JDMarc/albatross/output/airshot-pneumatics/instrument-eco-amber-inverse.png

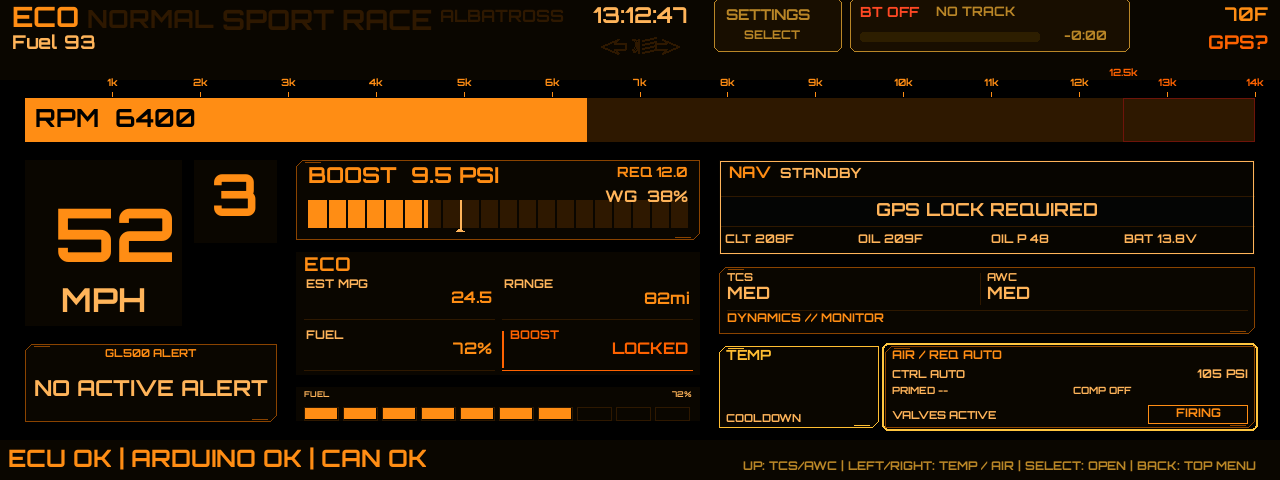
output/airshot-pneumatics/instrument-eco-amber-inverse.png
