JDMarc/albatross/output/airshot-pneumatics/instrument-eco-night-ops-inverse.png

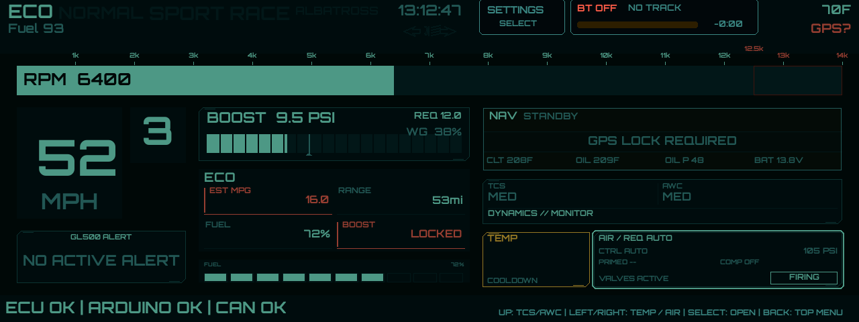
output/airshot-pneumatics/instrument-eco-night-ops-inverse.png
