JDMarc/albatross/output/airshot-pneumatics/instrument-sport-amber-inverse.png

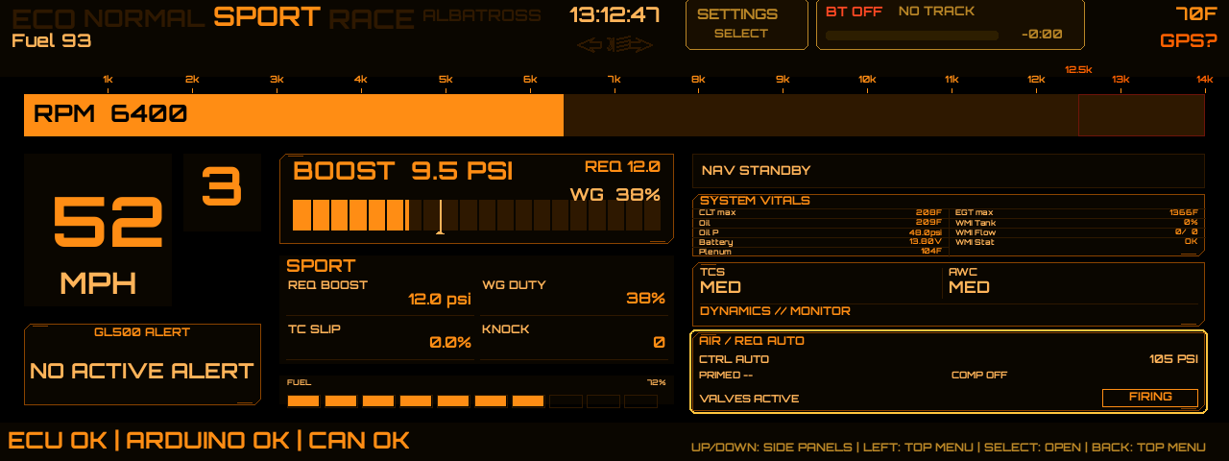
output/airshot-pneumatics/instrument-sport-amber-inverse.png
