JDMarc/albatross/output/airshot-pneumatics/instrument-sport-night-ops-inverse.png

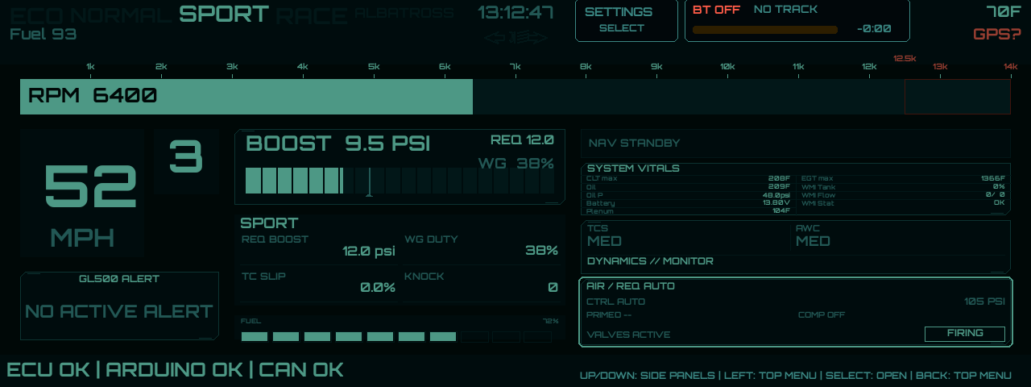
output/airshot-pneumatics/instrument-sport-night-ops-inverse.png
