JDMarc/albatross/output/post/startup-post-1280.png

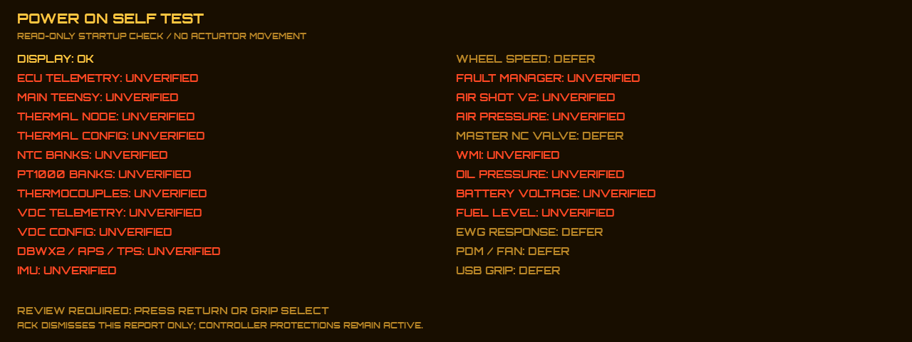
output/post/startup-post-1280.png
