JDMarc/albatross/output/post/startup-post-1920.png

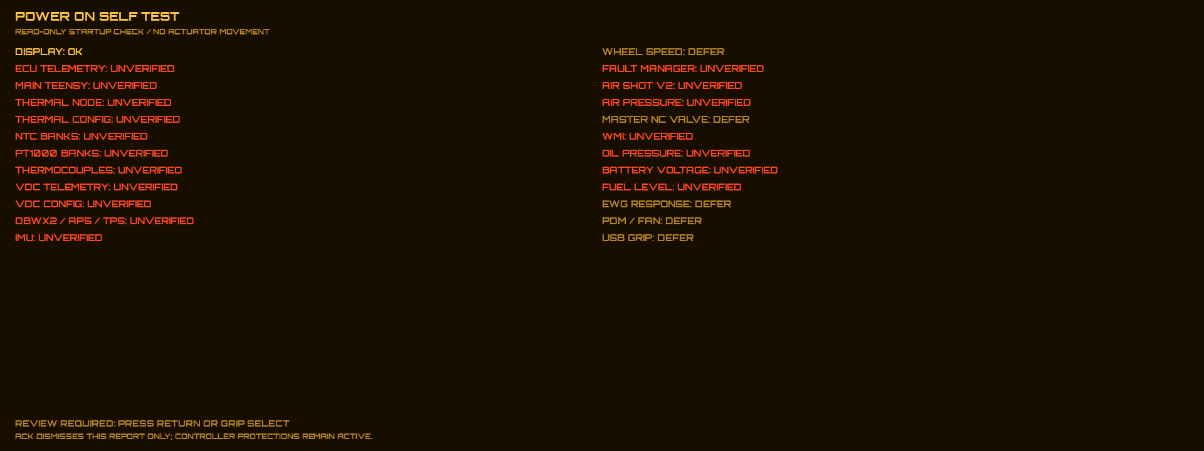
output/post/startup-post-1920.png
