JDMarc/albatross/arduino/teensy41/albatross_thermal_node/sensor_config.h

#pragma once
#include <Arduino.h>

enum class SensorTechnology : uint8_t { K_TYPE, IAT_NTC, COOLANT_NTC, PT1000, DISABLED };
enum class SourceBus : uint8_t { MAX31856, ADS1115, MAX31865, NONE };

struct SensorConfig {
  uint8_t id;
  const char* key;
  SensorTechnology technology;
  SourceBus bus;
  uint8_t channel;
  uint16_t sample_period_ms;
  uint16_t report_period_ms;
  float filter_tau_s;
  float derivative_tau_s;
  float minimum_c;
  float maximum_c;
  int32_t raw_minimum;
  int32_t raw_maximum;
  bool enabled;
  float pullup_ohm, r0_ohm, t0_c, beta_k;
};

constexpr size_t THERMAL_SENSOR_COUNT = 32;
extern const SensorConfig SENSOR_CONFIG[THERMAL_SENSOR_COUNT];
