JDMarc/albatross/(commit log)

2026-05-15 Add dual e-wastegate pins and wheel-speed CAN speedometer feed
2026-05-15 Align Arduino sketch pin mapping for Mega 2560 Rev3
2026-05-15 Fix Mega compile issues in Arduino sketch
    [albatross_controller.ino]
2026-05-16 Make HUD comm status line report FAULT when ECU/Arduino/CAN are absent
2026-05-16 Handle Windows UDP bind failures for demo listener with safe fallback
    [albatross_controller.ino, decode.py, ids.py]
2026-05-16 Fix demo responsiveness: dual UDP ports + live clock updates without telemetry
    [albatross_controller.ino, decode.py, ids.py]
2026-05-16 Add Arduino fuel telemetry path and large block-style HUD fuel gauge
2026-05-16 Expand safety supervisor for clutch-slip detection and critical-oil shutdown request logic
    [albatross_controller.ino, decode.py]
2026-05-16 Fix comm status false positives for Arduino/CAN with no telemetry
    [albatross_controller.ino, decode.py]
2026-05-16 Make POST render as typed terminal sequence with opaque background and staged results
2026-05-16 Fix demo UDP mapping and airshot charge selector
2026-05-16 Group CAN demo controls into ECU and Arduino sections
2026-05-16 Update README with accurate Arduino controller coverage
2026-05-16 Improve HUD media UI and show Bluetooth device list
2026-05-16 Fix menu focus gating and reposition right-side HUD controls
    [encode.py, ids.py]
2026-05-16 Prevent startup select bleed-through and tighten media tile control visibility
    [encode.py, ids.py]
2026-05-17 Fix selector positioning with right-anchored cluster layout
    [encode.py, ids.py]
2026-05-17 Fix CAN stale recovery using live-signal signature and align play time
    [encode.py, ids.py]
2026-05-17 Fix CAN stale clearing by tying freshness to inbound state updates
    [encode.py, ids.py]
2026-05-17 Add Bluetooth device submenu and phone telemetry sync
2026-05-17 Fix HUD clock progression when telemetry timestamps stall
2026-05-17 Fix temp POST sentinels and add battery voltage demo slider
    [decode.py, ids.py]
2026-05-17 Fix demo UDP mapping for coolant/oil temp and battery voltage
    [decode.py, ids.py]
2026-05-17 Add CAN engine run-switch kill path to safety supervisor
2026-05-17 Tune WMI flow to fuel/boost/load/rpm strategy
2026-05-17 Separate clutch-slip telemetry from AWC CAN payload
    [albatross_controller.ino, decode.py, ids.py]
2026-05-17 Relax clutch-slip fault trigger thresholds
    [albatross_controller.ino, decode.py, ids.py]
2026-05-17 Allow settings menu open when gear is unknown
2026-05-17 Clamp mode hover underline to header area
2026-05-17 Fix HUD mode selection flow
    [decode.py]
2026-05-17 Add motorcycle lighting status to HUD
2026-05-17 Audit CAN IDs and Mega pin assignments
2026-05-17 Update CAN demo generator frames
2026-05-17 Gate demo control command frames
2026-05-18 Align CAN plan with MS3Pro Mini sensor ownership
2026-05-20 Silence git probe in update packager
2026-05-20 Prevent update packager from including output
    [make_update_bundle.py]
2026-05-20 Document bike wiring pinout
2026-05-22 Clarify Arduino boost control safety
2026-05-23 Add GitHub online update flow
2026-05-23 Show raw CAN frames in UDP demo service mode
2026-05-23 Add night ops advisories and sensor confidence
2026-05-24 Add Air Shot failsafe shutoffs
    [albatross_controller.ino]
2026-05-25 Port controller firmware to Teensy 4.1
2026-05-25 Run Teensy boost loop at 200 Hz
2026-05-26 Add split-cylinder mismatch faults
2026-05-26 Tighten Air Shot and mode stats layouts
2026-05-26 Widen Air Shot charge indicators
2026-05-26 Center Air Shot charge blocks between readouts
2026-05-31 Give performance temperature grid more space
2026-06-01 Fix controller builds for Teensy toolchain
    [albatross_controller.ino, albatross_controller_teensy41.ino]
2026-07-08 Add Raspberry Pi CAN HAT deployment setup
2026-07-08 Simplify SocketCAN service for MCP2515 HATs
2026-07-08 Keep HUD running when python-can is missing
    [iface.py]
2026-07-08 Use modern python-can SocketCAN argument
2026-09-04 Add Air Shot V2 control, runtime calibration, and dual-input HUD modes
2026-09-05 Add latched powertrain stop and MT-07 commissioning safeguards
2026-09-05 Document dual Teensy architecture and current subsystem wiring
2026-09-05 Surface thermal faults and add episode-scoped error ignore
    [run_alert_checks.py]
2026-09-05 Open thermal menu on select and use directional heat-map navigation
2026-09-05 Add editable rider curve baselines and fixed 1:1 response
    [run_curve_checks.py, vdc.cpp, vdc_calibration.h, vdc_io.cpp]
2026-09-05 Render GL500 twin-turbo thermal architecture and fix spatial HUD navigation
    [run_home_navigation_checks.py, run_thermal_navigation_checks.py]
2026-09-05 Animate thermal flow paths and boost-driven turbo rotors
2026-09-05 Align cylinder fins and add avionics styling to thermal HUD
2026-09-05 Fix Settings access and Air Shot feedback; make thermal node primary
    [albatross_controller_teensy41.ino, decode.py]
2026-09-05 Restore inverted FIRING annunciator and refine cockpit instrument styling
    [run_instrument_style_checks.py]
2026-09-05 Redesign media menu with cockpit layout and scrolling device browser
    [run_media_checks.py]
2026-09-05 Fix Air Shot trailing usage budget and expire recovery profile context
    [airshot_budget.h, airshot_budget_test.cpp, airshot_controller.cpp, airshot_controller.h, airshot_core_test.cpp]
2026-09-06 Add isolated powered DBWX2 bench fixture and Air Shot provisions
    [bench_config.h, bench_core.h, bench_core_checks.cpp, bench_io_checks.cpp, bench_io_profile.h, dbw_bench.ino]
2026-09-06 Document full thermal wiring plan and correct CAN1 pin directions
    [thermal-sensor-wire-schedule.csv]
2026-09-08 Update thermal hardware, POST, Air Shot priming, HUD assets and documentation
    [thermal-sensor-wire-schedule.csv]
2026-09-09 Fix demo telemetry isolation and refresh contextual HUD vitals
    [run_can_demo_checks.py, run_context_panel_checks.py, run_vitals_rotation_checks.py]
